vampirehunt2/aniol64/Design.html

# Aniol64 design document

## Overview

Aniol64 is an 8-bit, Z80-based microcomputer with built-in keyboard, display and serial port as well as extendable IO

### Lead colour coding

Power supply: Blue or Purple
Ground: Black or Gray
Data: Red
Address: Green
Control: Yellow

Key rows: Red
Key coluns: Green
Special keys: Yellow

## Memory map

### Aniol 64

0000-7FFF: ROM (28C256)
8000-FFFF: RAM (62256 or 1244Y)

### Aniol 640

TBD

#### Bank switching schematic

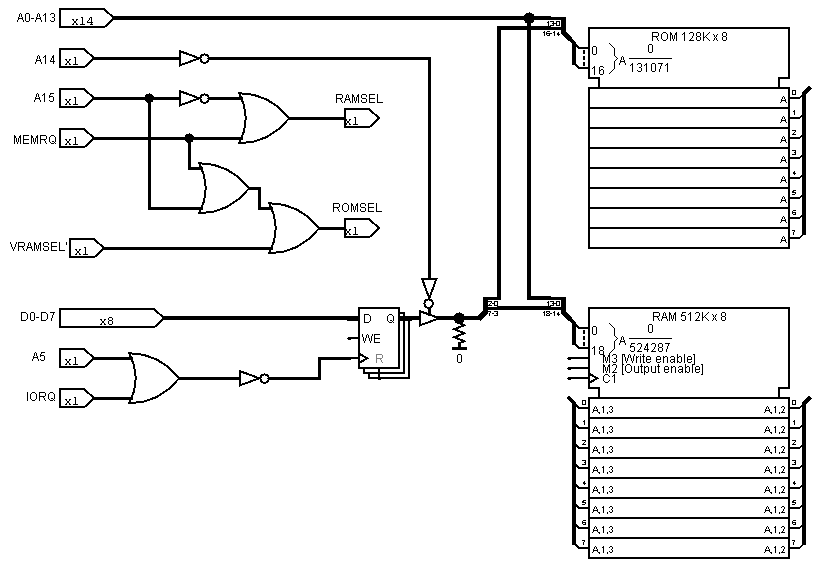
[picture p1: Design/bankSwitching.png]


## I/O

### Device address decoding

Address line | Address | Aniol 32 | Aniol 64 | Aniola 640
A0 | internal register select
A1 | internal register select
A2 | internal register select
A3 | 11110xxx | LCD display | Disk
A4 | 11101xxx | DART
A5 | 11011xxx | empty | | NVRAM bank switching
A6 | 10111xxx | keyboard/buzzer
A7 | 01111xxx | expansion

### Expansion port interface

Viewed from the front of the motherboard, left to right.

1. NMI (out)
2. INT (in)
3. +5V
4. GND
5. D0 (both)
6. D1 (both)
7. D2 (both)
8. D3 (both)
9. D4 (both)
10. D5 (both)
11. D6 (both)
12. D7 (both)
13. WR (out)
14. RD (out)
15. IORQ (out)
16. CLK (out)
17. A7 (out)
18. A2 (out)
19. A1 (out)
20. A0 (out)
21. M1 (out)
22. RESET (out)
23. WAIT (in)
24. IEO

## Keyboard

### Chipset

1. D-mux: '138
2. Mux: '151
3. Counter: '160x2
4. D: '74
5. Latch: '573
6. OR: '32
7. NOT: '14
8. AND: '08

### Key-side connector

1. R0
2. R1
3. R2
4. R3
5. C0
6. C1
7. C2
8. C3
9. C4
10. C5
11. C6
12. C7
13. ALT
14. SHIFT
15. +5V
16. GND

### CPU-side connector

1. INT
2. +5V
3. GND
4. D0
5. D1
6. D2
7. D3
8. D4
9. D5
10. D6
11. D7
12. WR
13. RD
14. IORQ
15. CLK
16. A6
17. M1
18. RESET
19. IEI
20. IEO/NMI

### Keyboard layout

normal | SHIFT | ALT | ALT+SHIFT
00 | 10 | 01 | 11

| | | | | | | | | | C0 | C5
| | C0 | C1 | C2 | C3 | C4 | C5 | C6 | C7 | R3 | R3
| | 000 | 001 | 010 | 011 | 100 | 101 | 110 | 111 | 11 | 11
R0 | 00 | qQ1! | wW2@ | eE3# | rR4$ | tT5% | yY6^ | uU7& | iI8* | oO9( | pP0)
R1 | 01 | aA+| | sS- | dD* | fF/ | gG= | hH[: | jJ] | kK[Up] | lL_ | \r,\d
R2 | 10 | SHIFT | ALT | zZ<{ | xX>} | cC?~ | vV.\ | bB[L]' | nN[Dn]" | mM[R]; | \s\t\b
| | | | | | | | | | C2 | C3

\s - space
\r - enter
\d - delete
\b - backspace
\t - tab

### Keyboard data lines

D6 - SHIFT
D5 - ALT
D4-D3 - Rows
D2-D0 - Cols

Keyboard codes:
S
H
IA   
FL
TT R  C
00-00-000b		q	71h
00-00-001b		w	77h
00-00-010b		e	65h
00-00-011b		r	72h
00-00-100b		t	74h
00-00-101b		y	79h
00-00-110b		u	75h
00-00-111b		i	69h
00-01-000b		a	61h
00-01-001b		s	73h
00-01-010b		d	64h
00-01-011b		f	66h
00-01-100b		g	67h
00-01-101b		h	68h
00-01-110b		j	6Ah
00-01-111b		k	6Bh
00-10-010b		z	7Ah
00-10-011b		x	78h
00-10-100b		c	63h
00-10-101b		v	76h
00-10-110b		b	62h
00-10-111b		n	6Eh
00-11-000b		o	6Fh
00-11-001b		l	6Ch
00-11-010b		m	6Dh
00-11-011b		\s	20h
00-11-100b		\r	0Dh
00-11-101b		p	70h

SHIFT:
10-00-000b		Q	51h
10-00-001b		W	57h
10-00-010b		E	45h
10-00-011b		R	52h
10-00-100b		T	54h
10-00-101b		Y	59h
10-00-110b		U	55h
10-00-111b		I	49h
10-01-000b		A	41h
10-01-001b		S	53h
10-01-010b		D	44h
10-01-011b		F	46h
10-01-100b		G	47h
10-01-101b		H	48h
10-01-110b		J	4Ah
10-01-111b		K	4Bh
10-10-010b		Z	5Ah
10-10-011b		X	58h
10-10-100b		C	43h
10-10-101b		V	56h
10-10-110b		B	42h
10-10-111b		N	4Eh
10-11-000b		O	4Fh
10-11-001b		L	4Ch
10-11-010b		M	4Dh
10-11-011b		\t	09h
10-11-100b		,	2Ch
10-11-101b		P	50h

ALT:
01-00-000b		1	31h
01-00-001b		2	32h
01-00-010b		3	33h
01-00-011b		4	34h
01-00-100b		5	35h
01-00-101b		6	36h
01-00-110b		7	37h
01-00-111b		8	38h
01-01-000b		+	2Bh
01-01-001b		-	2Dh
01-01-010b		*	2Ah
01-01-011b		/	2Fh
01-01-100b		=	3Dh
01-01-101b		[	5Bh
01-01-110b		]	5Dh
01-01-111b		[Up]	11h
01-10-010b		<	3Ch	
01-10-011b		>	3Eh
01-10-100b		?	3Fh
01-10-101b		.	2Eh
01-10-110b		[L]	12h
01-10-111b		[Dn]	13h
01-11-000b		9	39h
01-11-001b		_	5Fh
01-11-010b		[R]	14h
01-11-011b		\b	08h
01-11-100b		\d	7Fh
01-11-101b		0	30h

ALT+SHIFT
11-00-000b		!	21h
11-00-001b		@	40h
11-00-010b		#	23h
11-00-011b		$	24h
11-00-100b		%	25h
11-00-101b		^	5Eh
11-00-110b		&	26h
11-00-111b		*	2Ah
11-01-000b		|	7Ch
11-01-101b		:	3Ah
11-10-010b		{	7Bh
11-10-011b		}	7Dh
11-10-100b		~	7Eh
11-10-101b		\	5Ch
11-10-110b		'	27h
11-10-111b		"	22h
11-11-000b		(	28h
11-11-010b		;	3Bh
11-11-101b		)	29h

### Simple Keyboard connector

left to right

1. A0 (R0)
2. A1 (R1)
3. A2 (R2)
4. A3 (R3)
5. D0 (C0)
6. D1 (C1)
7. D2 (C2)
8. D3 (C3)
9. D4 (C4)
10. D5 (C5)
11. D6 (C6)
12. D7 (C7)

### Schematic

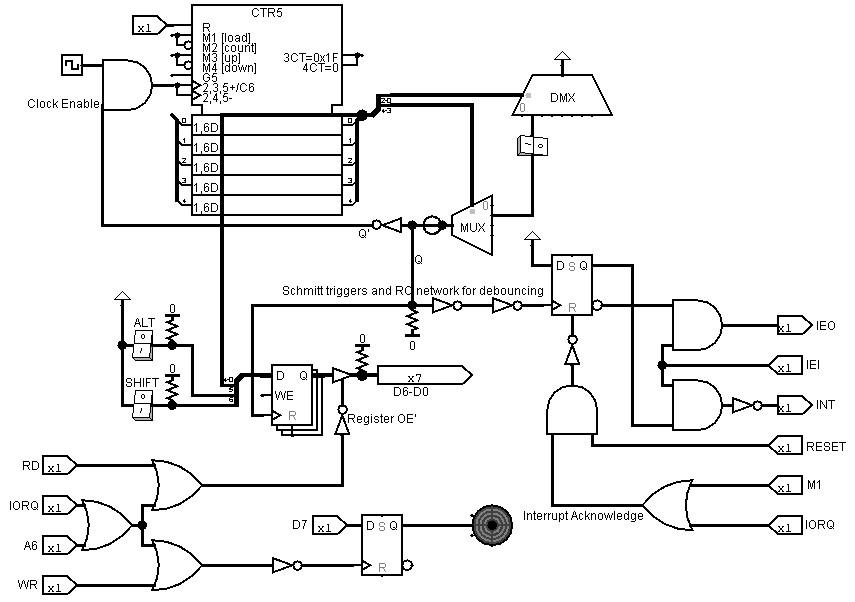
[picture p2: Design/keyboard-buzzer.png]


## LCD display

### CPU-side connector

1. +5V
2. D7
3. D6
4. D5
5. D4
6. D3
7. D2
8. D1
9. D0
10. GND
11. WR
12. RD
13. IORQ
14. A3
15. A1
16. A0

## VGA generation

### Schematic

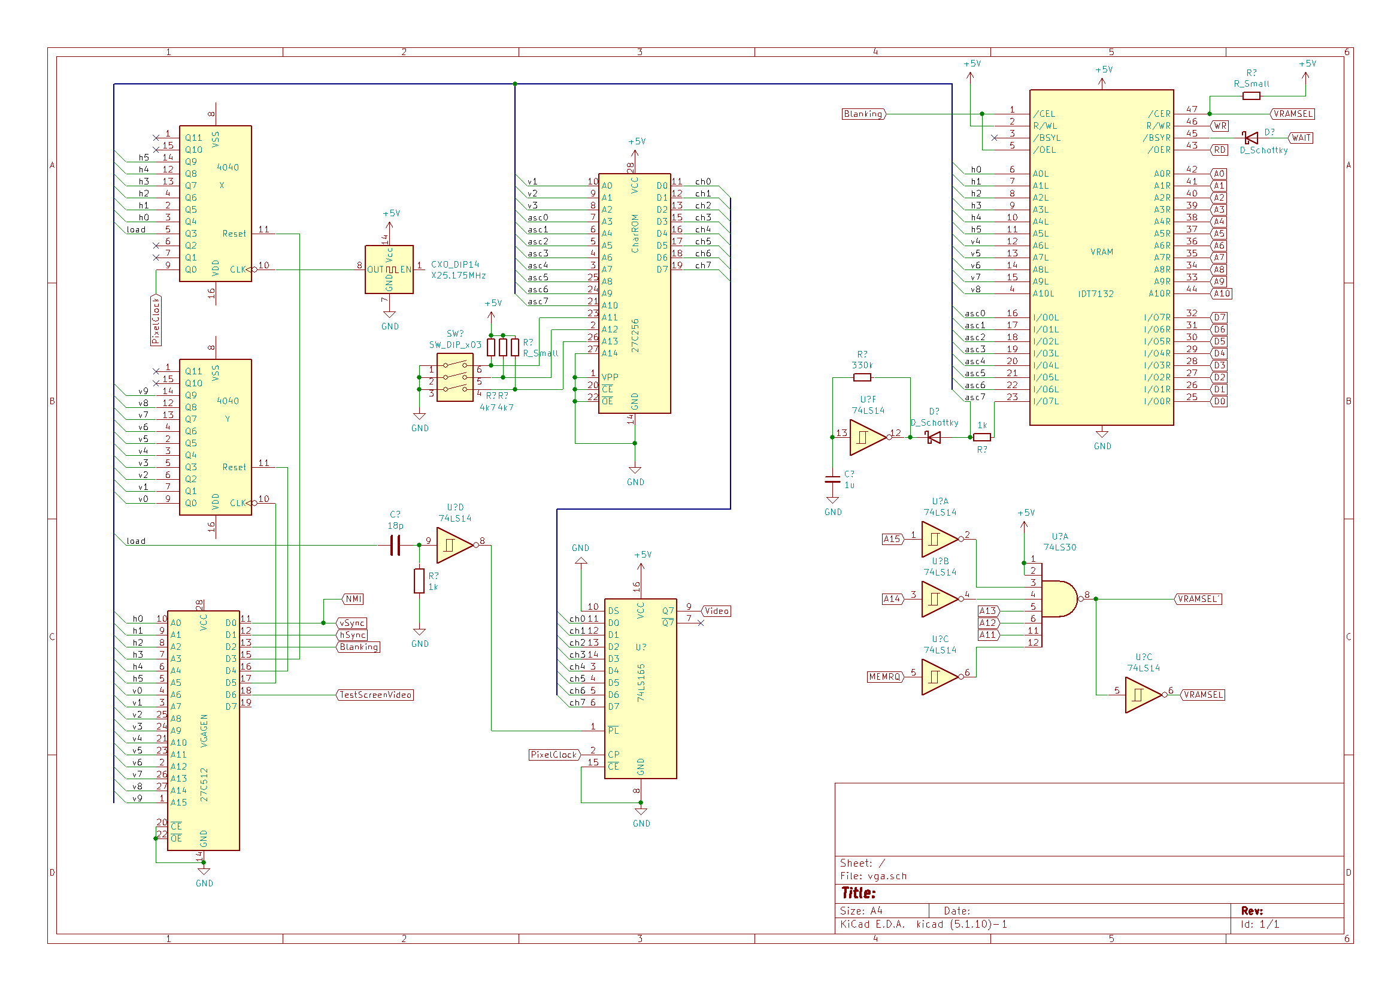
[picture p3: Design/VGAwithCharGen.png]


### Connector

Viewed from the conector side

1 | 2 | 3 | 4 | 5 | 6 | 7 | 8 | 9 | 10 | 11 | 12 | 13 | 14 | 15 | 16 | 17
A12 | A13 | A14 | Tx | Rx | D4 | D3 | D5 | D6 | +5V | D2 | D7 | D0 | D1 | NMI | A15+MEMRQ | IORQ+M1
A11 | A10 | A9 | A8 | A7 | A6 | A5 | A4 | A3 | A2 | A1 | A0 | WR | RD | CLK | VRAM' | GND

## Serial port

### Connector

Viewed from the conector side

1 | 2 | 3 | 4 | 5 | 6 | 7 | 8
nc | RxA | RxCA (in) | TxA | TxCA (in) | SyncA | CLKB (out) | GND
+5V | DTRB | CTSB | RTSB | DCDB | SyncB | TxB | RxB

## References

Komputer 8-bitowy (http://www.forum-trioda.pl/viewtopic.php?f=48&t=37948)
GIT repository (https://github.com/vampirehunt2/aniol64)
