vampirehunt2/aniol64/A32frontplate.png

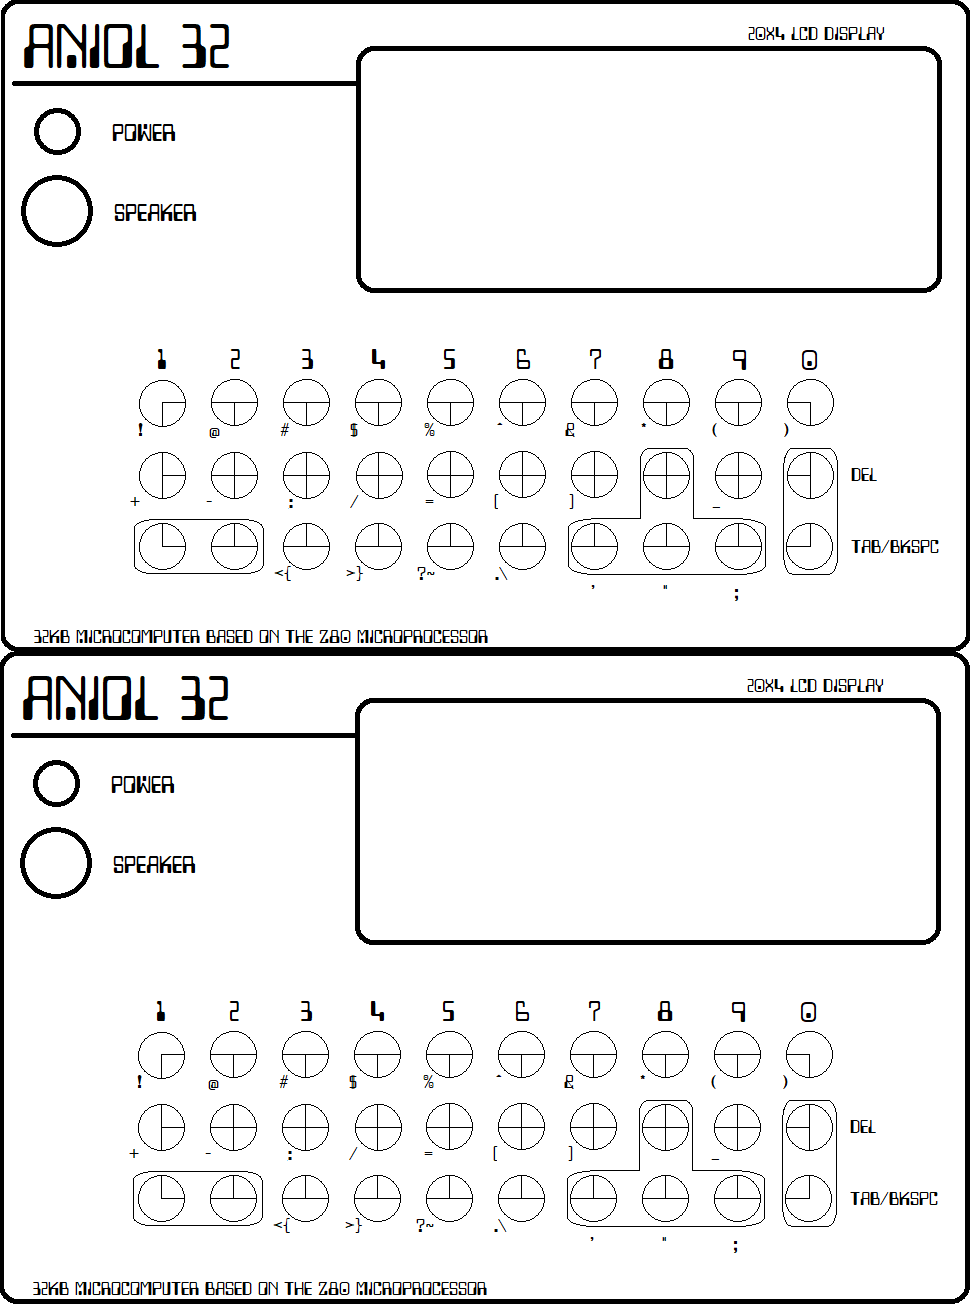
A32frontplate.png
