vampirehunt2/aniol64/A64kiCad/DART.png

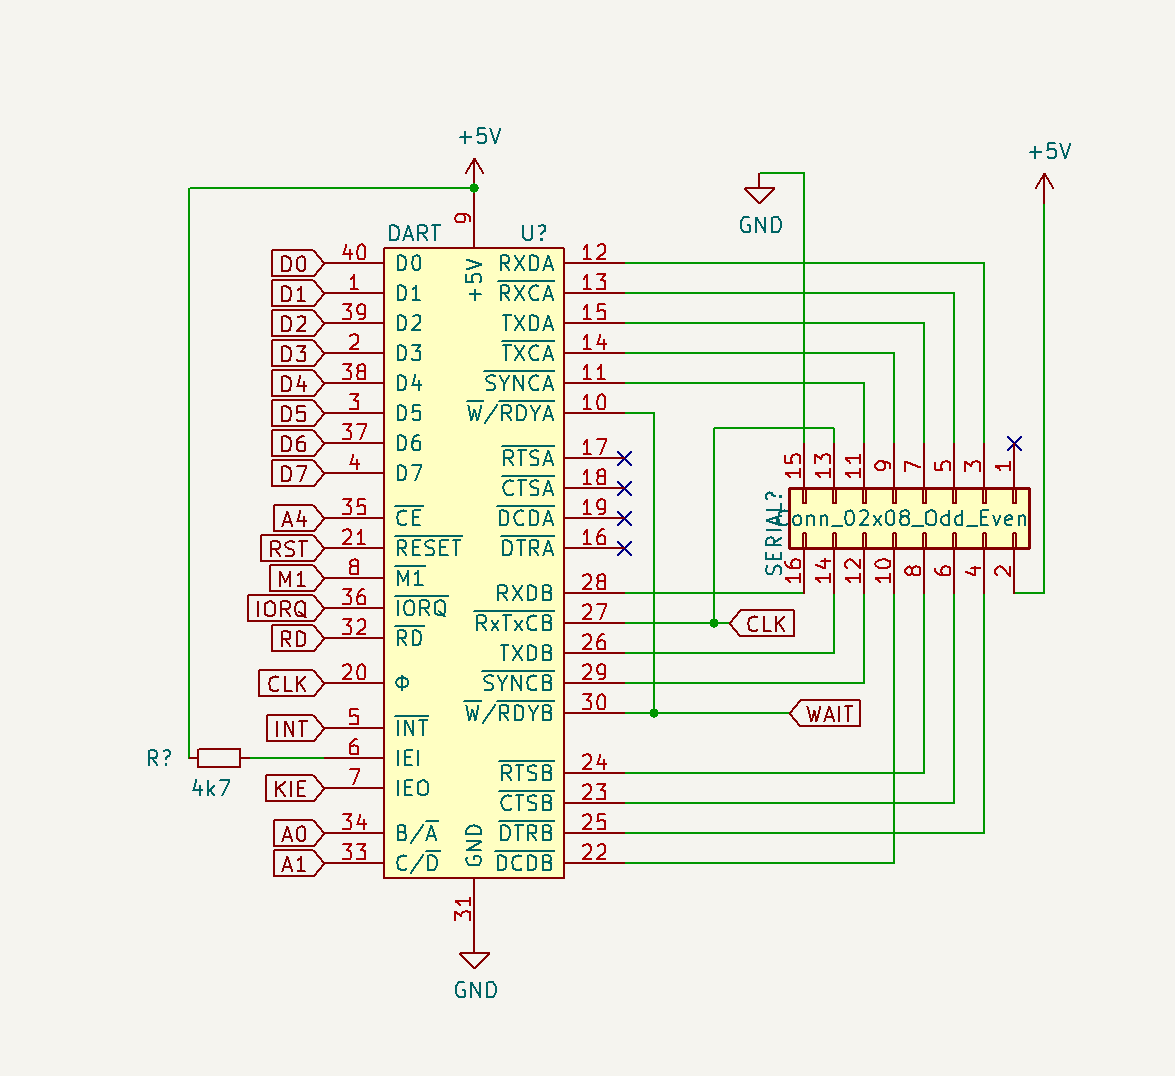
A64kiCad/DART.png
