vampirehunt2/aniol64/A64kiCad/main.png

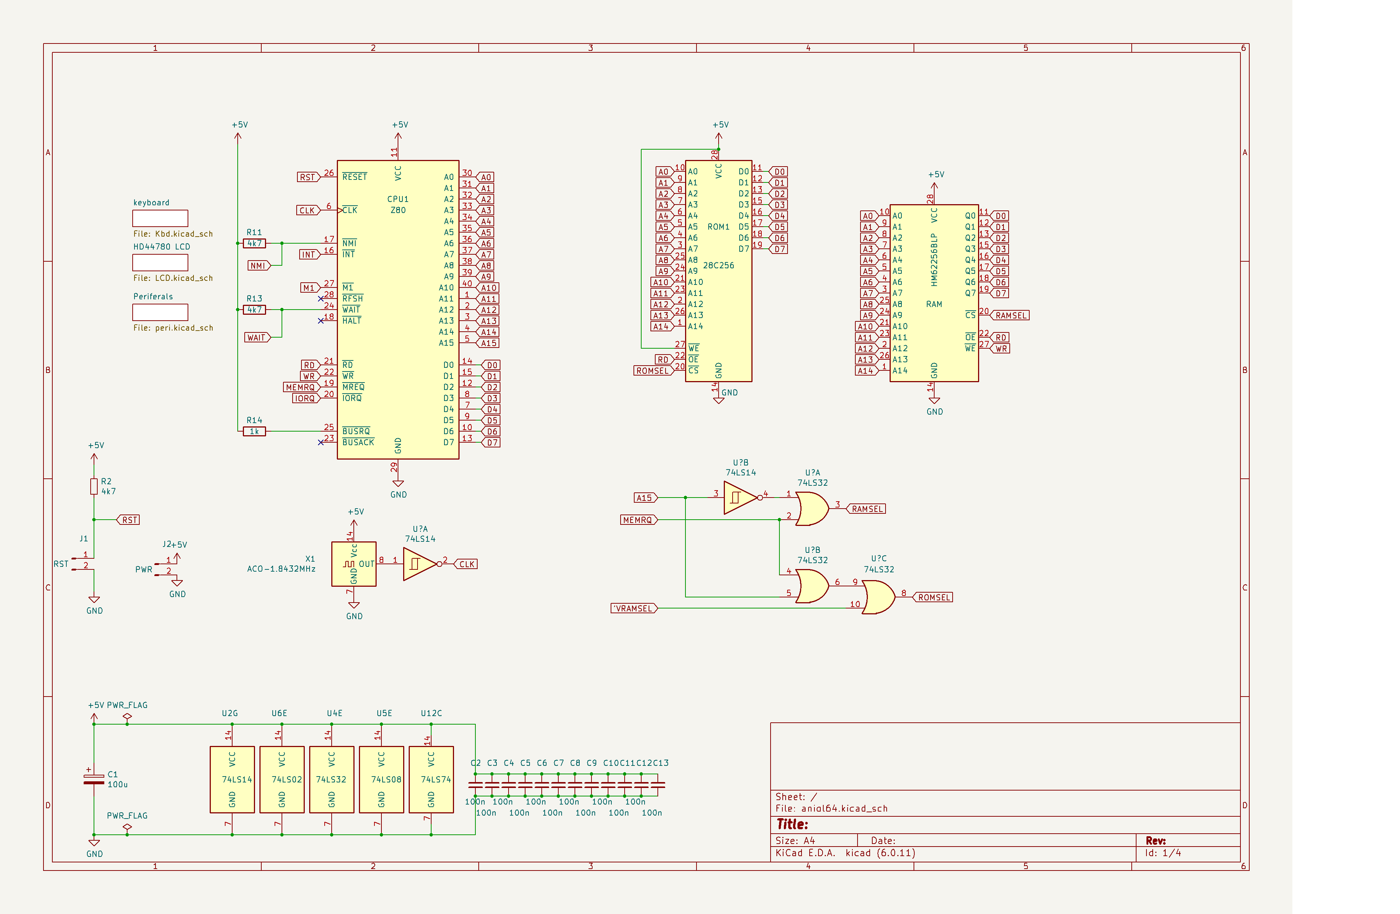
A64kiCad/main.png
