vampirehunt2/aniol64/A640frontplate.bmp

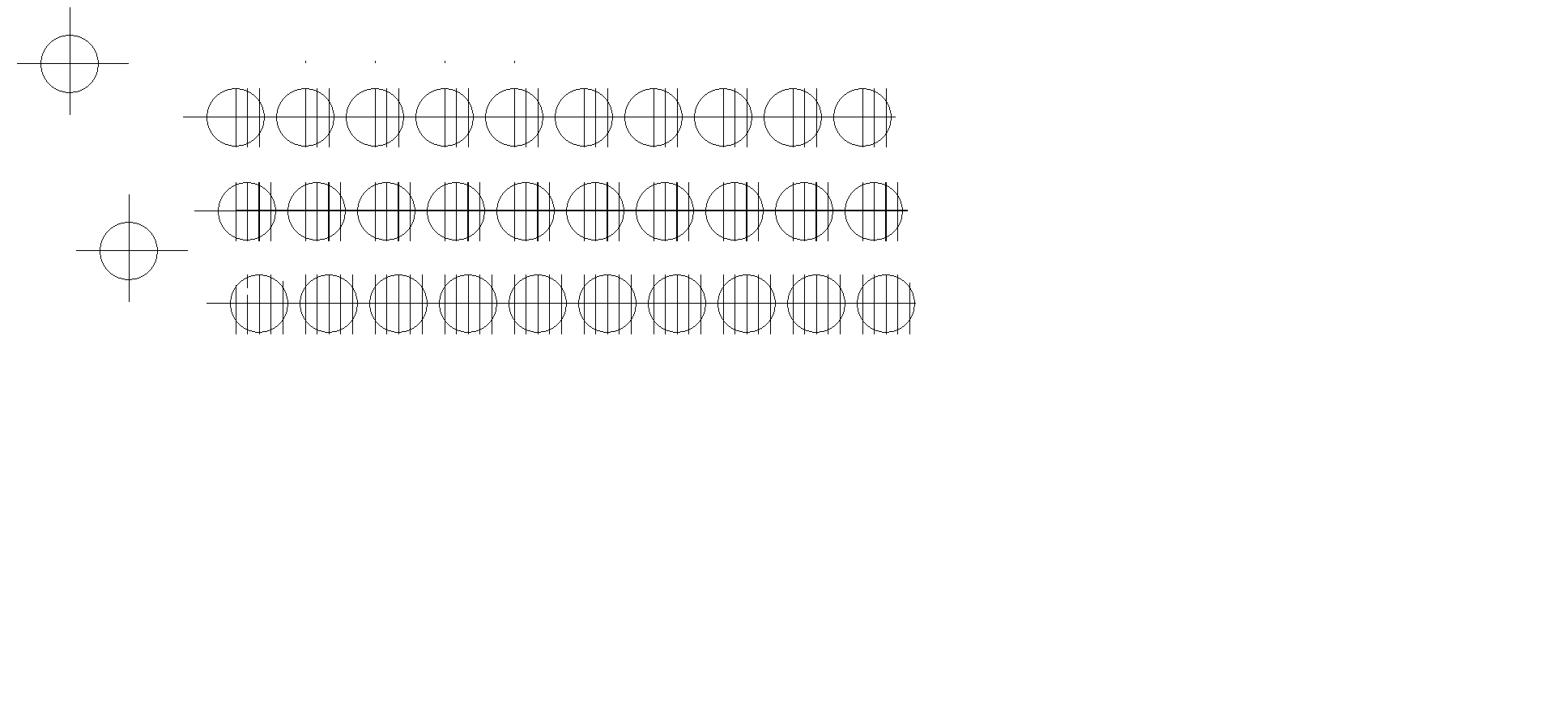
A640frontplate.bmp
