vampirehunt2/aniol64/A640frontplate.png

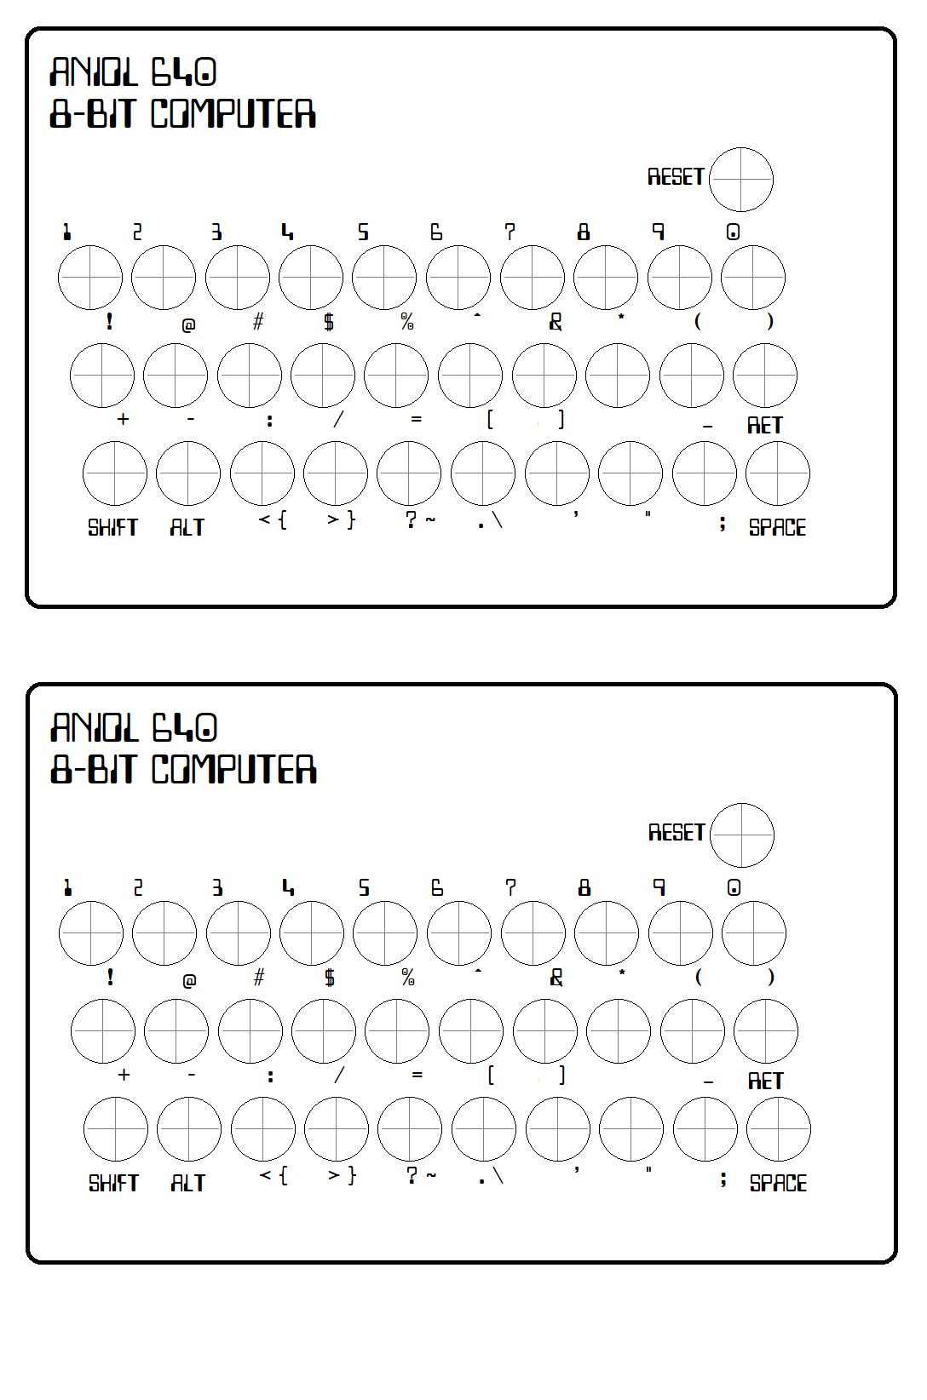
A640frontplate.png
