vampirehunt2/aniol64/Design/VgaGen.png

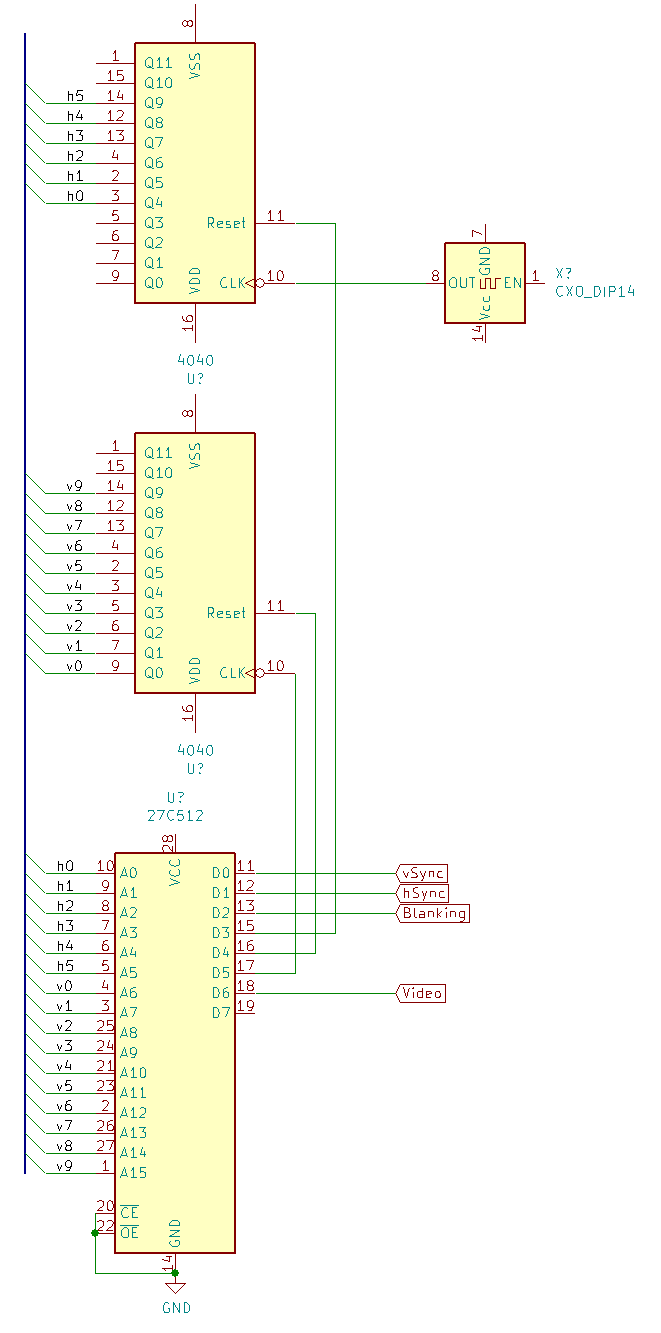
Design/VgaGen.png
