vampirehunt2/aniol64/kiCad/BitmappedGraphicsCard/colours.png

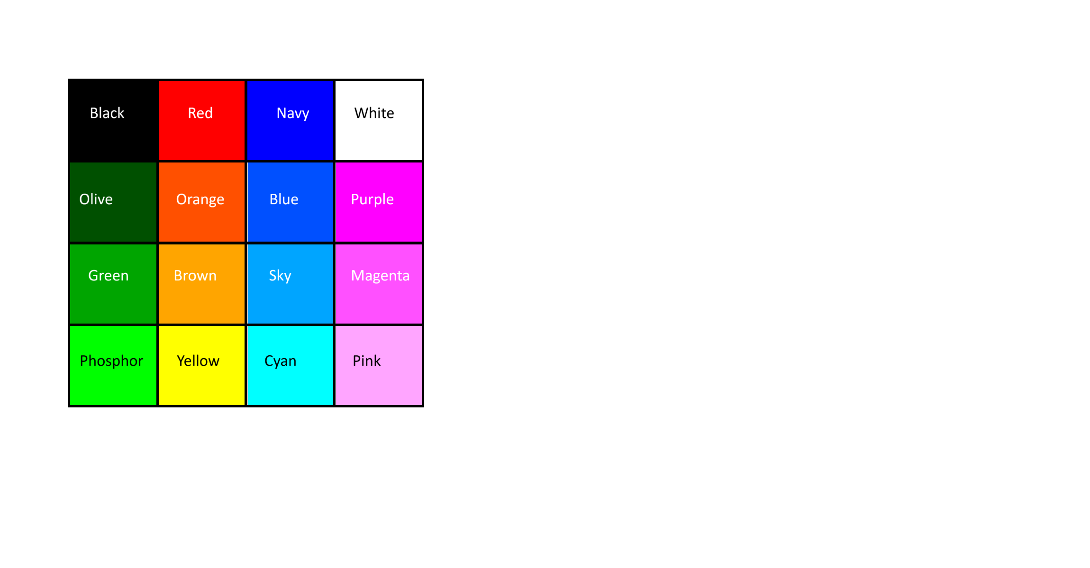
kiCad/BitmappedGraphicsCard/colours.png
