vampirehunt2/aniol64/membr.png

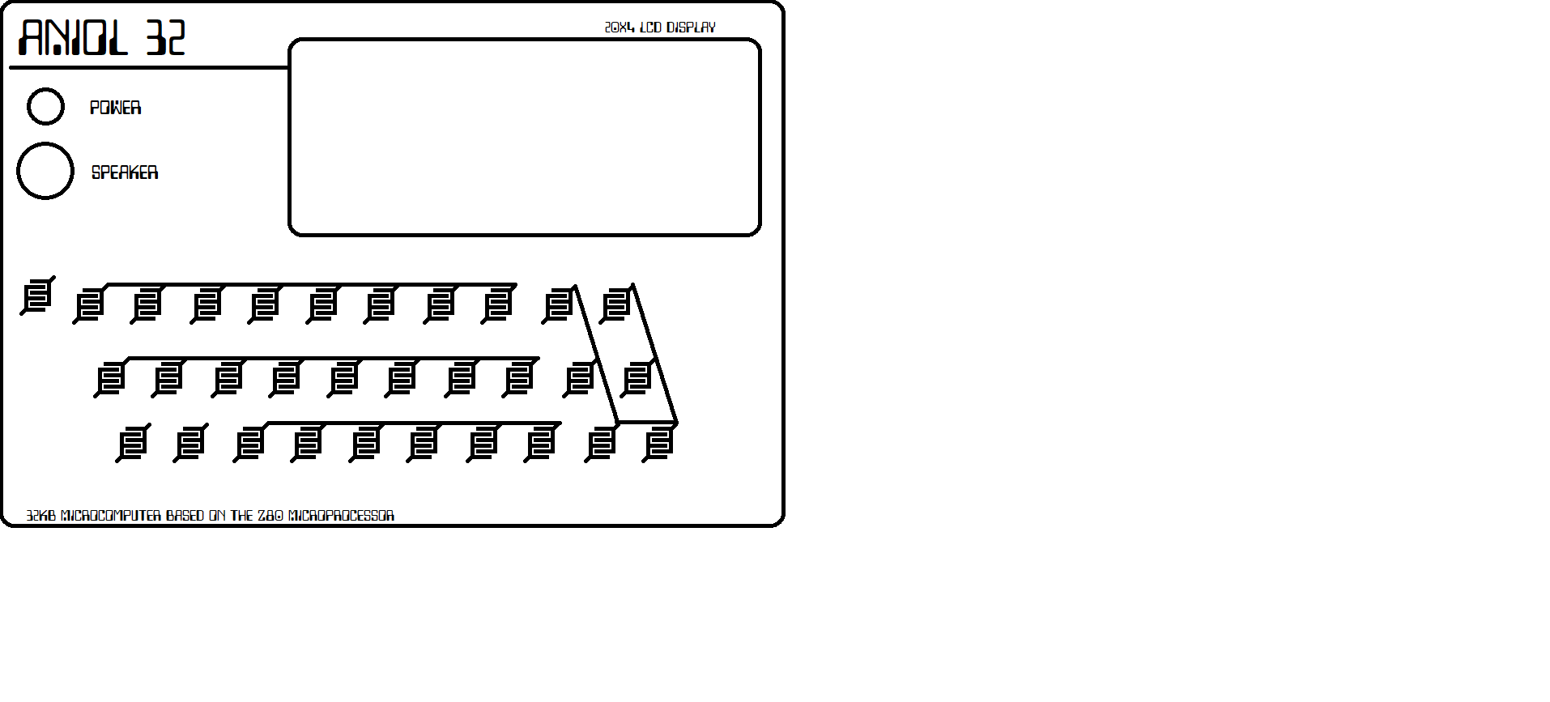
membr.png
