vampirehunt2/aniol64/workspace/PAL/GAL pinout.png

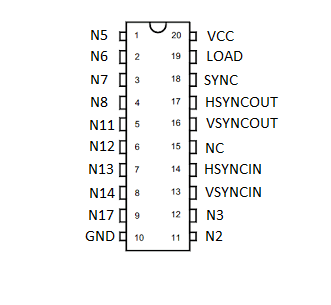
workspace/PAL/GAL pinout.png
