vampirehunt2/aniol64/(threads)

Thread 2 (2022-06-02):

bank switching stopped working

vampirehunt2, 2022-06-02:

vampirehunt2, 2022-06-10:
Replaced the '573, '32, '14

Closed 2022-06-10.
