vampirehunt2/aniol64/(list of files, drawings)

Other design files:
8085/ExpansionPort.circ
A64CPM/A64CPM.circ
A64memoryDecoding.circ
Aniol64keyboard.circ
Design/soundCardInterrupts.circ
kiCad/BitmappedGraphicsCard/AddressDecoding.circ
lcdDisplayAddressDecoding.circ
lcdDisplayNew.circ
memoryProtection.circ
ProgrammableCounter.circ
RAM512K.circ
RomBankSwitching.circ
VGA.circ
VideoRamAddressDecode.circ
VideoRAMSEL.circ
