vampirehunt2/aniol64/A32kiCad/aniol32.kicad_pcb

## KiCad design A32kiCad/aniol32.kicad_pcb (2022-03-04)

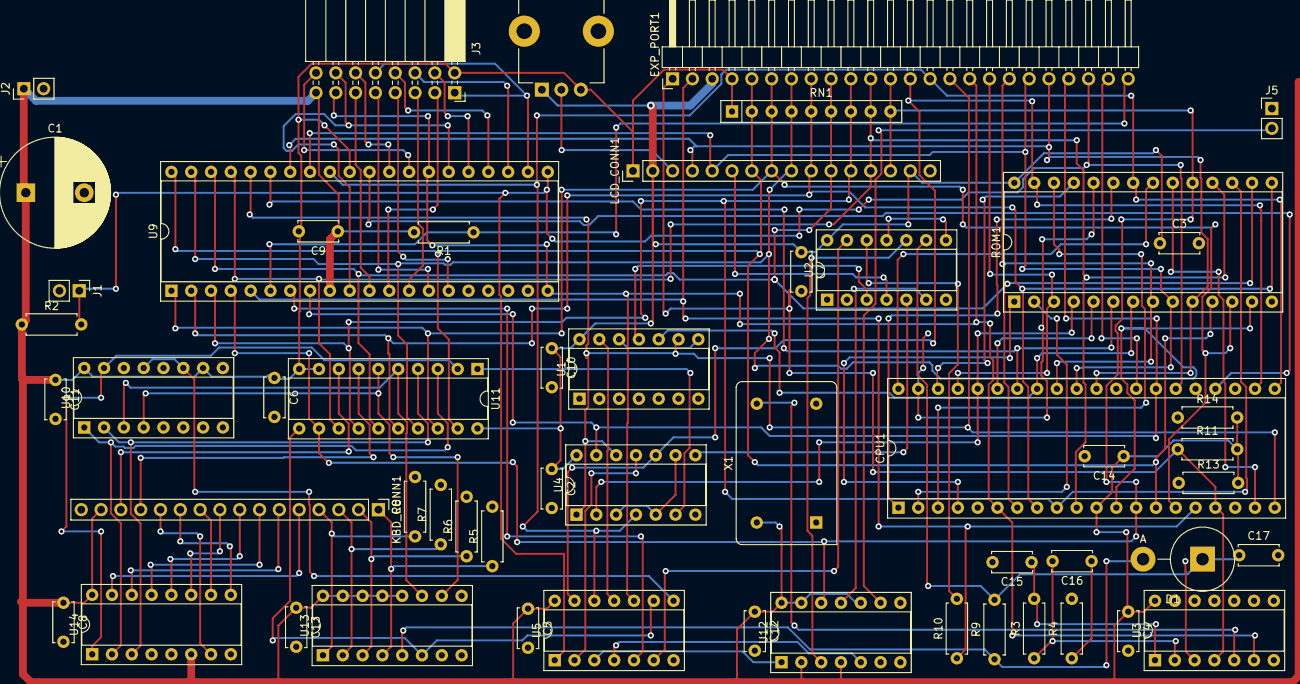
[picture p13: board aniol32.kicad_pcb from above]

Board: 2 copper layers, 54 parts (0 on the bottom side), 94 nets.

Parts:
C1: 100u; CP_Radial_D14.0mm_P7.50mm
C2, C3, C4, C5, C6, C7, C8, C9, C10, C11, C12, C13, C14, C17: 100n; C_Disc_D5.0mm_W2.5mm_P5.00mm
C15: 47n; C_Disc_D5.0mm_W2.5mm_P5.00mm
C16: 10n; C_Disc_D5.0mm_W2.5mm_P5.00mm
CPU1: Z80; DIP-40_W15.24mm_Socket
D1: D; D_5KPW_P7.62mm_Vertical_AnodeUp
EXP_PORT1: Conn_01x24_Male; PinHeader_1x24_P2.54mm_Horizontal
J1: RST; PinHeader_1x02_P2.54mm_Vertical
J2: PWR; PinHeader_1x02_P2.54mm_Vertical
J3: Conn_02x08_Odd_Even; PinSocket_2x08_P2.54mm_Horizontal
J5: Buzzer; PinHeader_1x02_P2.54mm_Vertical
KBD_CONN1: Conn_01x16_Male; PinHeader_1x16_P2.54mm_Vertical
LCD_CONN1: Conn_01x16_Male; PinHeader_1x16_P2.54mm_Vertical
R1, R2, R5, R6, R7, R8, R10, R11, R13: 4k7; R_Axial_DIN0207_L6.3mm_D2.5mm_P7.62mm_Horizontal
R3: 1M; R_Axial_DIN0207_L6.3mm_D2.5mm_P7.62mm_Horizontal
R4: 20k; R_Axial_DIN0207_L6.3mm_D2.5mm_P7.62mm_Horizontal
R9: 100k; R_Axial_DIN0207_L6.3mm_D2.5mm_P7.62mm_Horizontal
R14: 1k; R_Axial_DIN0207_L6.3mm_D2.5mm_P7.62mm_Horizontal
RN1: 8x4k7; R_Array_SIP9
ROM1: 28C256; DIP-28_W15.24mm_Socket
RV1: R_POT_TRIM; Potentiometer_TT_P0915N
U1, U4: 74LS32; DIP-14_W7.62mm_Socket
U2, U3: 74LS14; DIP-14_W7.62mm_Socket
U5: 74LS08; DIP-14_W7.62mm_Socket
U9: DART; DIP-40_W15.24mm_Socket
U10: 74LS590; DIP-16_W7.62mm_Socket
U11: 74LS573; DIP-20_W7.62mm_Socket
U12: 74LS74; DIP-14_W7.62mm_Socket
U13: 74LS151; DIP-16_W7.62mm_Socket
U14: 74LS138; DIP-16_W7.62mm_Socket
X1: ACO-1.8432MHz; Oscillator_DIP-14

Connections:
+5V: C1.1, C2.1, C3.1, C4.1, C5.1, C6.1, C7.1, C8.1, C9.1, C10.1, C11.1, C12.1, C13.1, C14.1, CPU1.11, EXP_PORT1.3, J2.1, J3.15, KBD_CONN1.15, LCD_CONN1.2, LCD_CONN1.15, R1.2, R2.1, R11.2, R13.2, R14.2, ROM1.28, RV1.1, U1.14, U2.14, U3.14, U4.14, U5.14, U9.9, U10.10, U10.16, U11.20, U12.2, U12.4, U12.10, U12.13, U12.14, U13.12, U13.13, U13.14, U13.15, U13.16, U14.6, U14.16, X1.14
A0: CPU1.30, EXP_PORT1.20, LCD_CONN1.4, ROM1.10, U9.34
A1: CPU1.31, EXP_PORT1.19, LCD_CONN1.5, ROM1.9, U9.33
A2: CPU1.32, EXP_PORT1.18, ROM1.8
A3: CPU1.33, ROM1.7, U1.10
A4: CPU1.34, ROM1.6, U9.35
A5: CPU1.35, ROM1.5
A6: CPU1.36, ROM1.4, U4.2
A7: CPU1.37, EXP_PORT1.17, ROM1.3
A8: CPU1.38, ROM1.25
A9: CPU1.39, ROM1.24
A10: CPU1.40, ROM1.21
A11: CPU1.1, ROM1.23
A12: CPU1.2, ROM1.2
A13: CPU1.3, ROM1.26
A14: CPU1.4, ROM1.1
ALT: KBD_CONN1.13, U11.7
C0: KBD_CONN1.5, U14.15
C1: KBD_CONN1.6, U14.14
C2: KBD_CONN1.7, U14.13
C3: KBD_CONN1.8, U14.12
C4: KBD_CONN1.9, U14.11
C5: KBD_CONN1.10, U14.10
C6: KBD_CONN1.11, U14.9
C7: KBD_CONN1.12, U14.7
CLK: CPU1.6, EXP_PORT1.16, J3.13, U3.6, U5.10, U9.20, U9.27
CONTRAST: LCD_CONN1.3, RV1.2
D0: CPU1.14, EXP_PORT1.5, LCD_CONN1.7, RN1.2, ROM1.11, U9.40, U11.19
D1: CPU1.15, EXP_PORT1.6, LCD_CONN1.8, RN1.3, ROM1.12, U9.1, U11.18
D2: CPU1.12, EXP_PORT1.7, LCD_CONN1.9, RN1.4, ROM1.13, U9.39, U11.17
D3: CPU1.8, EXP_PORT1.8, LCD_CONN1.10, RN1.5, ROM1.15, U9.2, U11.16
D4: CPU1.7, EXP_PORT1.9, LCD_CONN1.11, RN1.6, ROM1.16, U9.38, U11.15
D5: CPU1.9, EXP_PORT1.10, LCD_CONN1.12, RN1.7, ROM1.17, U9.3, U11.14
D6: CPU1.10, EXP_PORT1.11, LCD_CONN1.13, RN1.8, ROM1.18, U9.37, U11.13
D7: CPU1.13, EXP_PORT1.12, LCD_CONN1.14, RN1.9, ROM1.19, U9.4, U11.12, U12.12
GND: C1.2, C2.2, C3.2, C4.2, C5.2, C6.2, C7.2, C8.2, C9.2, C10.2, C11.2, C12.2, C13.2, C14.2, C15.2, C17.2, CPU1.29, EXP_PORT1.4, J1.2, J2.2, J3.2, J5.1, KBD_CONN1.16, LCD_CONN1.1, LCD_CONN1.16, R4.2, R5.2, R6.2, R7.2, R8.2, RN1.1, ROM1.14, RV1.3, U1.7, U2.7, U3.7, U4.7, U5.7, U9.31, U10.8, U10.12, U10.14, U11.9, U11.10, U12.7, U13.7, U13.8, U13.9, U14.4, U14.5, U14.8, X1.7
INT: CPU1.16, EXP_PORT1.2, R10.1, U9.5
IORQ: CPU1.20, EXP_PORT1.15, U1.9, U4.1, U4.12, U9.36
KIE: U5.5, U9.7
LCDE: LCD_CONN1.6, U2.4
LOAD: U5.9, U11.11, U13.6
M1: CPU1.27, EXP_PORT1.21, U4.13, U9.8
MEMRQ: CPU1.19, ROM1.20
NMI: CPU1.17, EXP_PORT1.1, R11.1, U3.4
unnamed: C15.1, R3.2, U3.1
unnamed: C16.1, R4.1, U3.3
unnamed: C16.2, R3.1, U3.2
unnamed: C17.1, D1.1, R9.2, U2.9
unnamed: CPU1.25, R14.1
unnamed: D1.2, R9.1, U13.5
unnamed: EXP_PORT1.24, R1.1, U9.6
unnamed: J3.3, U9.12
unnamed: J3.4, U9.25
unnamed: J3.5, U9.13
unnamed: J3.6, U9.23
unnamed: J3.7, U9.15
unnamed: J3.8, U9.24
unnamed: J3.9, U9.14
unnamed: J3.10, U9.22
unnamed: J3.11, U9.11
unnamed: J3.12, U9.29
unnamed: J3.14, U9.10, U9.26
unnamed: J3.16, U9.28
unnamed: J5.2, U12.9
unnamed: R10.2, U2.12
unnamed: U1.11, U2.3
unnamed: U1.8, U1.12
unnamed: U1.13, U5.11
unnamed: U2.5, U4.8
unnamed: U2.8, U2.11
unnamed: U2.13, U5.6
unnamed: U3.5, X1.8
unnamed: U4.3, U4.5, U4.9
unnamed: U4.11, U5.2
unnamed: U10.1, U11.3, U14.2
unnamed: U10.2, U11.4, U14.3
unnamed: U10.3, U11.5, U13.11
unnamed: U10.4, U11.6, U13.10
unnamed: U5.8, U10.11, U10.13
unnamed: U10.15, U11.2, U14.1
unnamed: U4.6, U11.1
unnamed: U5.3, U12.1
unnamed: U2.10, U12.3
unnamed: U5.4, U12.5
unnamed: U2.6, U12.11
R0: KBD_CONN1.1, R5.1, U13.4
R1: KBD_CONN1.2, R6.1, U13.3
R2: KBD_CONN1.3, R7.1, U13.2
R3: KBD_CONN1.4, R8.1, U13.1
RD: CPU1.21, EXP_PORT1.14, ROM1.22, U4.4, U5.12, U9.32
RST: CPU1.26, EXP_PORT1.22, J1.1, R2.2, U5.1, U9.21
SHIFT: KBD_CONN1.14, U11.8
WAIT: CPU1.24, R13.1, U9.30
WR: CPU1.22, EXP_PORT1.13, ROM1.27, U4.10, U5.13
