vampirehunt2/aniol64/kiCad/8751/test/test.kicad_pcb

## KiCad design kiCad/8751/test/test.kicad_pcb (2025-09-07)

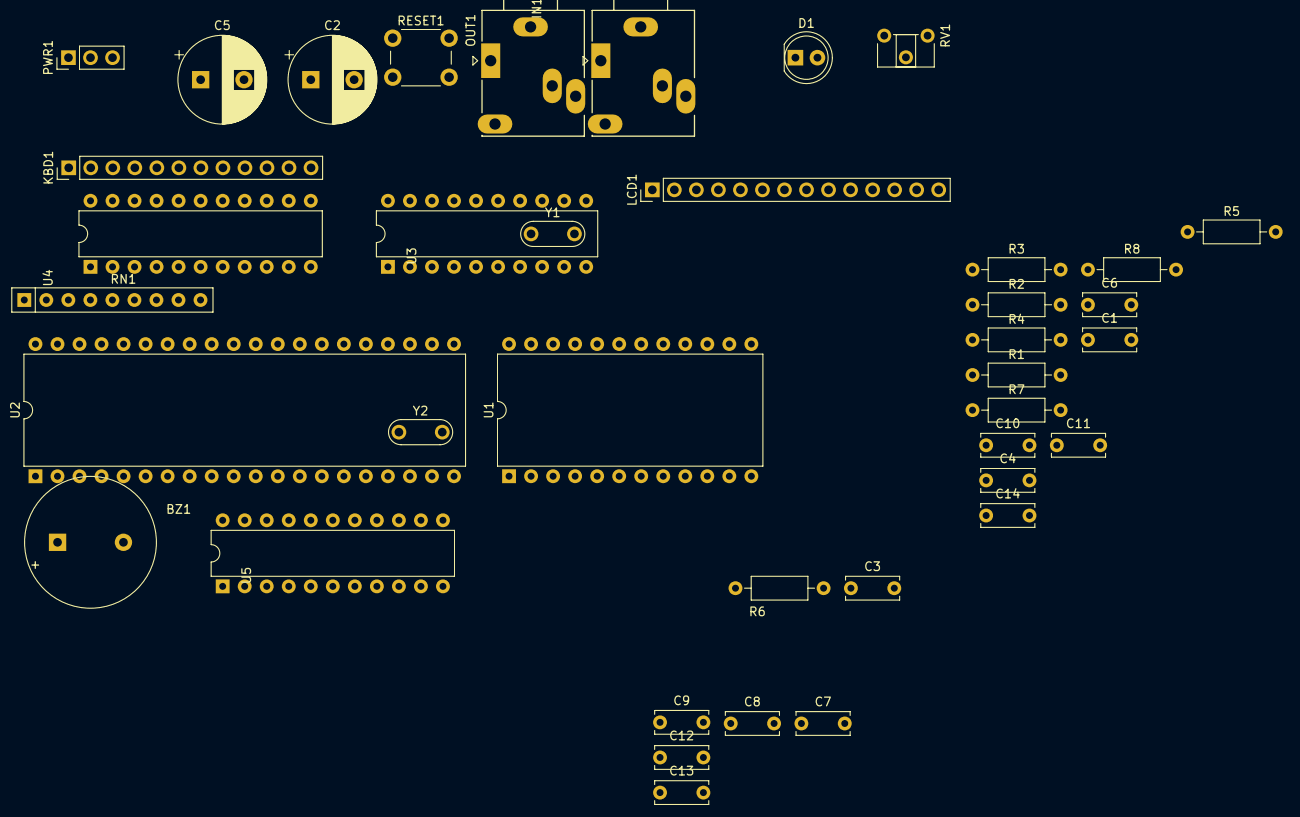
[picture p14: board test.kicad_pcb from above]

Board: 2 copper layers, 39 parts (0 on the bottom side), 67 nets, no tracks yet.

Parts:
BZ1: Buzzer; Buzzer_15x7.5RM7.6
C1, C6, C7, C9, C10, C12, C13, C14: 100n; C_Disc_D6.0mm_W2.5mm_P5.00mm
C2, C5: C_Polarized; CP_Radial_D10.0mm_P5.00mm
C3, C4: 27p; C_Disc_D6.0mm_W2.5mm_P5.00mm
C8, C11: 18p; C_Disc_D6.0mm_W2.5mm_P5.00mm
D1: LED; LED_D5.0mm
IN1: AudioJack3; Jack_3.5mm_Ledino_KB3SPRS_Horizontal
KBD1: KBD; PinHeader_1x12_P2.54mm_Vertical
LCD1: LCD; PinHeader_1x14_P2.54mm_Vertical
OUT1: AudioJack3; Jack_3.5mm_Ledino_KB3SPRS_Horizontal
PWR1: Conn_01x03_Male; PinHeader_1x03_P2.54mm_Vertical
R1: 10k; R_Axial_DIN0207_L6.3mm_D2.5mm_P10.16mm_Horizontal
R2, R3: R_Small; R_Axial_DIN0207_L6.3mm_D2.5mm_P10.16mm_Horizontal
R4: 600; R_Axial_DIN0207_L6.3mm_D2.5mm_P10.16mm_Horizontal
R5, R6, R7, R8: 1k; R_Axial_DIN0207_L6.3mm_D2.5mm_P10.16mm_Horizontal
RESET1: SW_SPST; SW_PUSH_6mm
RN1: 470; R_Array_SIP9
RV1: 5k; Potentiometer_ACP_CA6-H2,5_Horizontal
U1: 6116; DIP-24_W15.24mm
U2: 87c51; DIP-40_W15.24mm
U3: MC14544x; DIP-20_W7.62mm
U4: 74LS541; DIP-22_W7.62mm
U5: 74LS574; DIP-22_W7.62mm
Y1: 3.58MHz; Resonator-2Pin_W7.0mm_H2.5mm
Y2: 12MHz; Resonator-2Pin_W7.0mm_H2.5mm

Connections:
+5V: C2.1, C7.1, C9.1, C12.1, C13.1, C14.1, LCD1.2, R3.2, RESET1.2 (B), RN1.1 (common), RV1.1, U1.24 (VCC), U2.31 (EA#/VPP), U2.40 (VCC), U3.6 (VDD), U4.20 (VCC), U5.20 (VCC)
/A0: R5.1, U1.8 (A0), U5.19 (Q0)
/A1: R6.1, U1.7 (A1), U5.18 (Q1)
/A2: R7.1, U1.6 (A2), U5.17 (Q2)
/A3: R8.1, U1.5 (A3), U5.16 (Q3)
/A4: U1.4 (A4), U5.15 (Q4)
/A5: U1.3 (A5), U5.14 (Q5)
/A6: U1.2 (A6), U5.13 (Q6)
/A7: U1.1 (A7), U5.12 (Q7)
/A8: U1.23 (A8), U2.21 (P2.0_(A8))
/A9: U1.22 (A9), U2.22 (P2.1_(A9))
/A10: U1.19 (A10), U2.23 (P2.2_(A10))
/D0: RN1.2 (R1), U1.9 (Q0), U2.39 (P0.0_(AD0)), U4.18 (Y0), U5.2 (D0)
/D1: RN1.3 (R2), U1.10 (Q1), U2.38 (P0.1_(AD1)), U4.17 (Y1), U5.3 (D1)
/D2: RN1.4 (R3), U1.11 (Q2), U2.37 (P0.2_(AD2)), U4.16 (Y2), U5.4 (D2)
/D3: RN1.5 (R4), U1.13 (Q3), U2.36 (P0.3_(AD3)), U4.15 (Y3), U5.5 (D3)
/D4: RN1.6 (R5), U1.14 (Q4), U2.35 (P0.4_(AD4)), U4.14 (Y4), U5.6 (D4)
/D5: RN1.7 (R6), U1.15 (Q5), U2.34 (P0.5_(AD5)), U4.13 (Y5), U5.7 (D5)
/D6: RN1.8 (R7), U1.16 (Q6), U2.33 (P0.6_(AD6)), U4.12 (Y6), U5.8 (D6)
/D7: RN1.9 (R8), U1.17 (Q7), U2.32 (P0.7_(AD7)), U4.11 (Y7), U5.9 (D7)
GND: BZ1.2 (+), C1.1, C3.2, C4.2, C5.2, C6.2, C7.2, C8.2, C10.2, C11.2, C12.2, C13.2, C14.2, IN1.S, LCD1.1, OUT1.S, PWR1.2, R1.2, R2.2, RV1.3, U1.12 (GND), U2.20 (GND), U3.2 (~LB), U3.12 (VSS), U3.14 (SQT), U4.10 (GND), U5.1 (OE), U5.10 (GND)
KBDEN: U2.27 (P2.6_(A14)), U4.1 (G1)
LCDEN: LCD1.6, U2.12 ((INT0#)_P3.2)
unnamed: BZ1.1 (-), U2.13 ((INT1#)_P3.3)
unnamed: C1.2, U3.4 (CDT)
unnamed: C3.1, U3.8 (XOUT), Y1.1
unnamed: C4.1, U3.9 (XIN), Y1.2
unnamed: C5.1, D1.2 (A), PWR1.1
unnamed: C6.1, U3.10 (FB)
unnamed: C8.1, U2.18 (XTAL2), Y2.1
unnamed: C9.2, C10.1, U3.18 (EXL), U3.19 (VAG)
unnamed: C11.1, U2.19 (XTAL1), Y2.2
unnamed: D1.1 (K), R2.1
unnamed: IN1.T, R4.2, U3.15 (RxA2)
unnamed: KBD1.1, R5.2
unnamed: KBD1.2, R6.2
unnamed: KBD1.3, R7.2
unnamed: KBD1.4, R8.2
unnamed: KBD1.5, U4.2 (A0)
unnamed: KBD1.6, U4.3 (A1)
unnamed: KBD1.7, U4.4 (A2)
unnamed: KBD1.8, U4.5 (A3)
unnamed: KBD1.9, U4.6 (A4)
unnamed: KBD1.10, U4.7 (A5)
unnamed: KBD1.11, U4.8 (A6)
unnamed: KBD1.12, U4.9 (A7)
unnamed: LCD1.3, RV1.2
unnamed: LCD1.7, U2.1 (P1.0)
unnamed: LCD1.8, U2.2 (P1.1)
unnamed: LCD1.9, U2.3 (P1.2)
unnamed: LCD1.10, U2.4 (P1.3)
unnamed: LCD1.11, U2.5 (P1.4)
unnamed: LCD1.12, U2.6 (P1.5)
unnamed: LCD1.13, U2.7 (P1.6)
unnamed: LCD1.14, U2.8 (P1.7)
unnamed: OUT1.T, U3.17 (TxA)
unnamed: R3.1, U3.20 (TLA)
unnamed: R4.1, U3.16 (RxA1)
unnamed: U2.30 (ALT/PROG#), U5.11 (Cp)
RAMCS: U1.18 (~CS), U2.28 (P2.7_(A15))
RD: U1.20 (~OE), U2.17 ((RD#)_P3.7), U4.19 (G2)
RS: LCD1.4, U2.14 ((T0)_P3.4)
RST: C2.2, R1.1, RESET1.1 (A), U2.9 (RESET)
RW: LCD1.5, U2.15 ((T1)_P3.5), U3.13 (MODE)
Rx: U2.10 ((RXD)_P3.0), U3.5 (RxD)
Tx: U2.11 ((TXD)_P3.1), U3.11 (TxD)
WR: U1.21 (~WE), U2.16 ((WR#)_P3.6)
