vampirehunt2/aniol64/(commit log)

2021-10-12 Fixed keyboard trigger
    [trigger.circ]
2021-10-13 Changed Keyboard layout
    [Aniol64keyboard.circ, memoryProtection.circ]
2021-10-13 tidied up schematics
    [Aniol64keyboard.circ, memoryProtection.circ]
2021-10-13 tidied up the keyboard schematic again
    [Aniol64keyboard.circ]
2021-10-15 Added 512KB RAM design.
    [RAM512K.circ]
2021-10-17 Created HTML documentation
    [trigger.circ]
2021-10-18 Added CUPL
    [RAM512K.circ]
2021-10-20 LCD timing changes, added buzzer to keyboard
    [Aniol64keyboard.circ]
2021-10-20 More doc cleanup
    [Aniol64keyboard.circ]
2021-10-26 sound stuff added
    [Aniol64keyboard.circ, soundCardInterrupts.circ]
2021-10-27 fixes in YM2413 support
    [soundCardInterrupts.circ]
2021-10-30 started DS1244 clock support. started defining the PL0+ grammar
    [Aniol64keyboard.circ]
2021-10-31 Added gating to keyboard latch signal
    [Aniol64keyboard.circ]
2021-10-31 chose VGA mode
    [VGA.circ]
2021-11-03 added RAM + ROM bank switching design
    [RomBankSwitching.circ, VideoRAMSEL.circ]
2021-11-04 corrected a bug in keyboard echo handling
    [VGA.circ]
2021-11-04 modified the keyboard schematic to work with IEO of other devices
    [Aniol64keyboard.circ]
2021-11-07 support for mode2 keyboard interrupts
    [Aniol64keyboard.circ, ProgrammableCounter.circ]
2021-11-09 adding the aniol32 kiCad schematic
    [Kbd.sch, LCD.sch, aniol32.kicad_pcb, aniol32.sch]
2021-11-09 Introduced hierarchical design in KiCad
    [DART.sch, Kbd.sch, LCD.sch, aniol32.sch, exp.sch]
2021-11-09 filling in the schematic
    [Kbd.sch, aniol32.sch]
2021-11-11 some changes to schematic and var
    [Kbd.sch]
2021-11-20 started mon implementation
    fixed bug in calling str_tok causing echo failure
    [counter.kicad_pcb, counter.sch]
2021-11-24 added AvrVga
    [TcfTransactionLog.csv, counter.sch]
2021-12-15 first attempts at generating VGA signal
    [vga.kicad_pcb, vga.sch]
2022-01-01 lots of changes
    [Kbd.sch, LCD.sch, aniol32.sch, exp.sch]
2022-01-01 tidying up the schematic
    [aniol32.sch]
2022-01-03 created cal.asm, parsing is working for single-byte hex numbers, 5 operations and brackets
    [aniol32.sch]
2022-01-17 added bitmapped text bin file generator
    [Kbd.sch, aniol32.kicad_pcb, aniol32.sch]
2022-01-18 Updated the VRAM address decoding
    [RomBankSwitching.circ, VideoRamAddressDecode.circ]
2022-01-21 added VGA ROM image and schematic
    [vga.sch]
2022-01-21 updated bank switching schematic
    [RomBankSwitching.circ]
2022-01-26 working on the calculator and the A32 pcb
    [aniol32.kicad_pcb, vga.sch]
2022-02-02 updated the VGA schematic with a shift register
    [vga.sch]
2022-02-08 Added variables for A32
    [membraneKeyboard.kicad_pcb, membraneKeyboard.sch]
2022-02-10 New A32 PCB layout
    With CPU closer to the memory
    [aniol32.kicad_pcb]
2022-02-18 adding font handling programs and fonts.
    [VramAddressDecode.kicad_pcb, VramAddressDecode.sch, aniol32.kicad_pcb, file62114DD8.sch, vga.sch]
2022-02-20 added bank switching routines
2022-02-20 tidied up the PCB
    [Kbd.sch, aniol32.kicad_pcb, aniol32.sch]
2022-02-20 defined track and via width for +5V power
2022-03-04 Doc changes
    Removed a '32 from A32
    Documented the VGA connector
    [Kbd.sch, LCD.sch, aniol32.kicad_pcb, aniol32.sch, lcdDisplayNew.circ, openCollector.kicad_pcb, openCollector.sch, vga.sch]
2022-03-10 updated schematics, memory bank switching code and memory map documentation
    [DART.sch, Kbd.sch, LCD.sch, VramAddressDecode.kicad_pcb, VramAddressDecode.sch, aniol64.kicad_pcb, aniol64.sch, counter.kicad_pcb]
2022-03-10 Adding A64 single chip memory decoder (minus Video RAM)
    [A64memoryDecoding.circ]
2022-03-26 corrections to the VGA schematic, added vga.asm
    [A64memoryDecoding.circ, RomBankSwitching.circ, vga.sch]
2022-03-26 added print to the faceplate
2022-03-31 fixed a bug in RAM bank switching procedure
2022-04-02 created A640 kiCad chematic
    [DART.sch, Kbd.sch, LCD.sch, VramAddressDecode.kicad_pcb, VramAddressDecode.sch, aniol640.kicad_pcb, aniol640.sch, counter.kicad_pcb]
2022-04-04 fixes in keyboard schematic, writing procedures for the VGA card
    [Kbd.sch, aniol640.sch]
2022-04-06 Simple keyboard progress
    [8464Decoding.kicad_pcb, 8464Decoding.sch, Kbd.sch, LCD.sch, aniol32.sch, simpleKbd.kicad_pcb, simpleKbd.sch]
2022-04-15 Added simple keyboard and put command in cmd
    [simpleKbd.sch]
2022-04-19 developing the skbd module
    [Kbd.sch, LCD.sch, aniol32.sch, aniol640.sch, file6262EA80.sch]
2022-05-05 switched completely from LCD to VGA
2022-05-11 moved dev drivers and utils to separate folders
    [file6262EA80.sch, vga.sch]
2022-05-16 working two-way serial terminal
    tested to work at 38.4kbaud
    [cassetteInterface.kicad_pcb, cassetteInterface.sch]
2022-05-30 Compact Flash interface
    [file6262EA80.sch, file62C4CC9D.sch, soundcard.kicad_pcb, soundcard.sch, vga.sch]
2022-06-02 Added a procedure to print out the CF signature
2022-06-05 added list capabilities to get, insert and remove at a given index
2022-09-11 Added basic PS2 keyboard support
    [aniol640.sch, peri.sch]
2022-09-13 Updated the schematic
    - added inverted DART clock
    - added power-up reset
    - changed to the more simplified ROM address decoding
    - removed battery backup for RAM
    [aniol640.sch, peri.sch]
2022-10-19 8088 project added
    [8088.kicad_pcb, 8088.sch, Ps2keyboardAdapter.kicad_pcb, Ps2keyboardAdapter.sch, aniol640.sch]
2022-11-09 stable with ps2 support
    [soundcard.sch, z180.kicad_pcb, z180.sch]
2023-01-02 Updated schematic of the CP/M card
    [A64CPM.circ]
2023-01-09 switched from using a dumb kbd to a ps2 keyboard
2023-01-24 Update Design.html
    Corrected the input/output pin descriptions in the expansion interface.
2023-01-26 Fixed missing Echo initialisation
    [ps2.asm]
2023-01-27 Fixed a bug in gotoXY
    [tm.asm]
2023-01-28 Made PS2 readKey to be non-interrupt driven
2023-01-29 Update tm.asm
    Fixed a bug where writeStr was destroying IX
    [tm.asm]
2023-02-04 Resetting the keyboard upon startup
    [ps2.asm, tm.asm]
2023-02-11 Update ps2.asm
    Fixed bug that caused readKey return 0 on keyUp
    [ps2.asm]
2023-02-11 Update tm.asm
    Revert changes related to PS2 keyboard initialisation. This is now completely handled in ps2.asm using DART Channel A only
    [tm.asm]
2023-02-28 separate handling of brackets
    also, fixed a bug in number processing
2023-03-10 fix the bug that was causing transmit to not be enabled
    [tm.asm]
2023-03-15 Added cleaniing up old binaries prior to assembly
2023-03-15 fixed untracked files
    [8085.kicad_pcb, 8085.kicad_sch, BitmappedGraphicsCard.kicad_sch]
2023-03-22 removed expansion buffering
    [Kbd.kicad_sch, LCD.kicad_sch, aniol64.kicad_sch, peri.kicad_sch]
2023-04-01 added scrolling in edit
    [Kbd.kicad_sch, aniol64.kicad_sch, peri.kicad_sch]
2023-04-13 fixed bug in clrScr in VGA driver
    where clrScr was not moving the cursor to 0,0
2023-05-01 Added pal card driver
2023-06-19 schematic updates
    [8085.kicad_sch, BitmappedGraphicsCard.kicad_sch, VGACard2.kicad_pcb]
2023-06-29 Square bracket as index operator
2023-10-29 8085 expansion port schematic
    [ExpansionPort.circ]
2024-01-15 serial keyboard
    [87c51keyboard.kicad_pcb, aniol51.kicad_pcb, keyboard.kicad_pcb]
2024-02-05 updated 8085 expansion port schematic
    [ExpansionPort.circ]
2024-02-13 fixed a bug with cat on vga not printing newlines
2024-05-19 Lower and Upper case procedures
2024-05-19 8085 kicad
    [aniol85.kicad_pcb]
2024-10-21 integrated cp/m into A64
    [8085.kicad_pcb, 8088.kicad_pcb, 8088.sch, 8464Decoding.kicad_pcb, 8464Decoding.sch, AddressDecoding.circ, BitmappedGraphicsCard.kicad_sch, DART.sch]
2025-03-08 Switched from 512 to 256 byte sectors
2025-04-13 completed drums prototype
2025-04-23 Moved the BitmappedVgaCard schematics to a new folder
    [8085.kicad_pcb, AddressDecoding.circ]
2025-05-17 Sorting out sequencer bugs
    - hanging when changing instruments
    - switch bouncing
2025-09-07 final commit on old computer
    [8751.kicad_pcb, A64mk2.kicad_pcb, Drums.kicad_pcb, test.kicad_pcb]
2025-11-05 colour vga driver
    [A64mk2.kicad_pcb]
2025-11-13 Converted Altair BASIC to z80 assembly
2025-11-13 modified the assembler executable path
2026-03-29 Fixing bugs in the 80 column driver
2026-04-06 changed WAIT to CLK in the graphics card connector pinout
2026-04-17 Added a serial connector section
2026-06-05 Refactored NMI handler
    Also, fixed the greeting reverse colour bug
    [aniol32.sch]
